tudsat-rocket/rapid_fancyfins/connector_pcb/connector_pcb.step

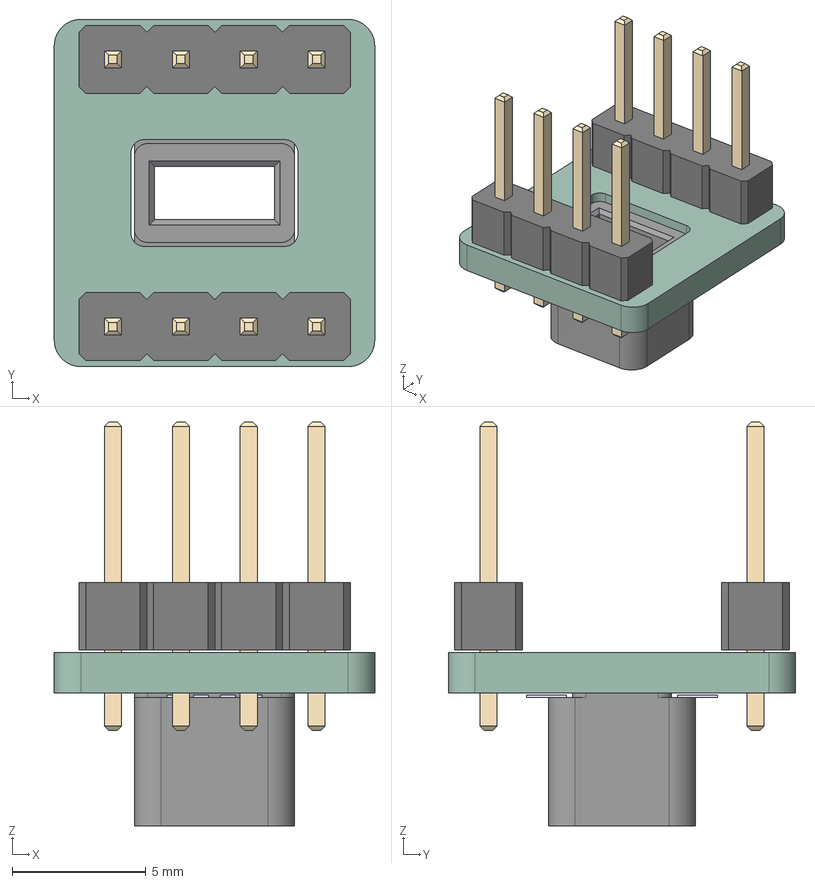
[picture p1: CAD file, 2025-07-23]
connector_pcb/connector_pcb.step
12.0 x 13.0 x 15.1 mm
PinHeader_1x04_P2.54mm_Vertical x 2
Pins
connector_pcb_PCB
