tudsat-rocket/rapid_fancyfins/fancyfins/frodo_fancyfins.step

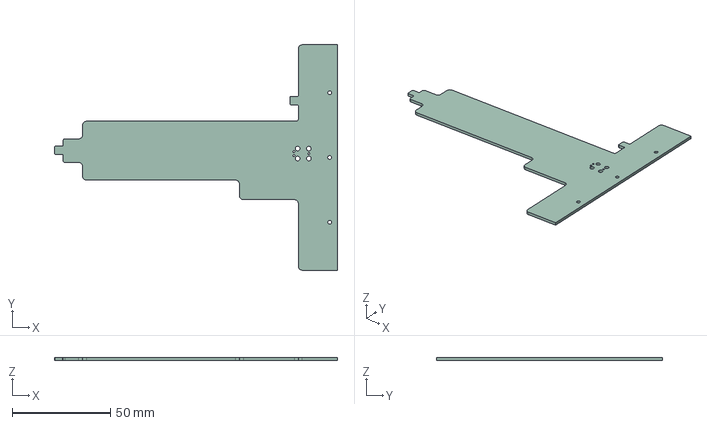
[picture p2: CAD file, 2025-07-23]
fancyfins/frodo_fancyfins.step
144.3 x 115.0 x 1.51 mm
