tudsat-rocket/rapid_fancyfins/sensor_pcb/sensor_pcb.step

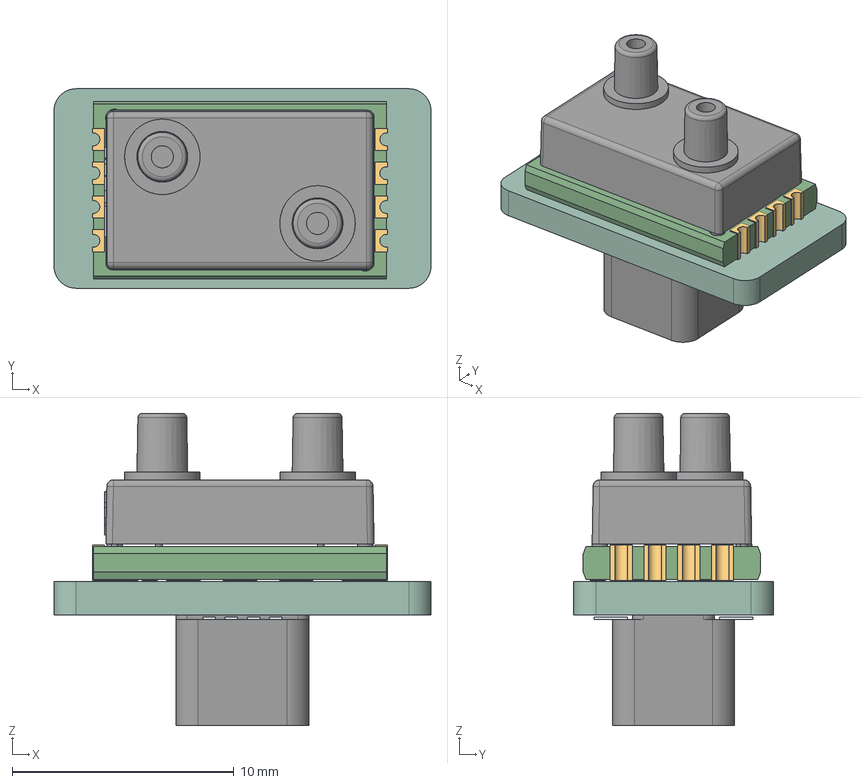
[picture p3: CAD file, 2025-07-23]
sensor_pcb/sensor_pcb.step
17.0 x 9.00 x 14.1 mm
8k_cover_V-strt_2.step
WE_logo.step
hpsd8000_PCBfull
Pins
sensor_pcb_PCB
