tudsat-rocket/rapid_fancyfins/common/3dmodels/STP_WL-ICLED_1313210530000.stp

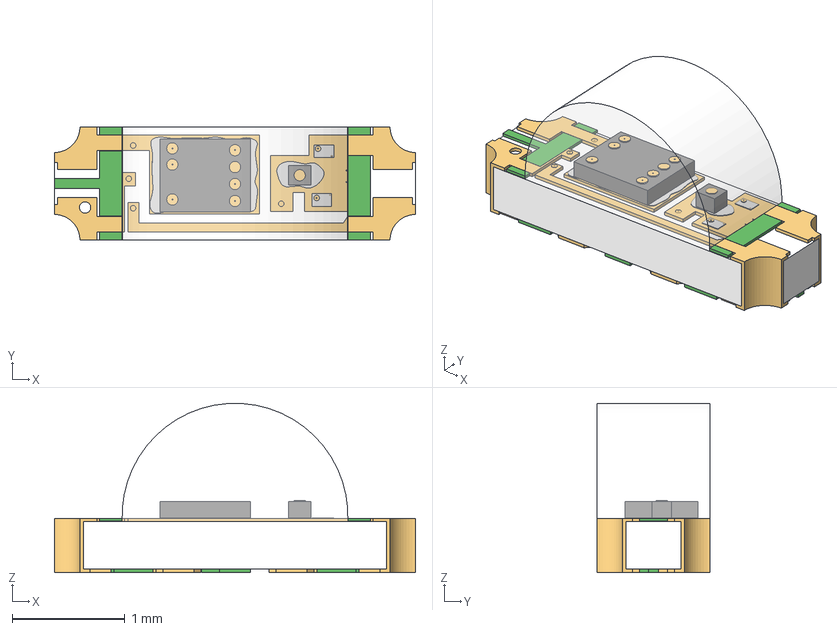
[picture p4: CAD file, 2025-03-25]
common/3dmodels/STP_WL-ICLED_1313210530000.stp
3.20 x 1.00 x 1.50 mm
Contacts
Resin
