tudsat-rocket/rapid_fancyfins/common/3dmodels/009159008801906.step

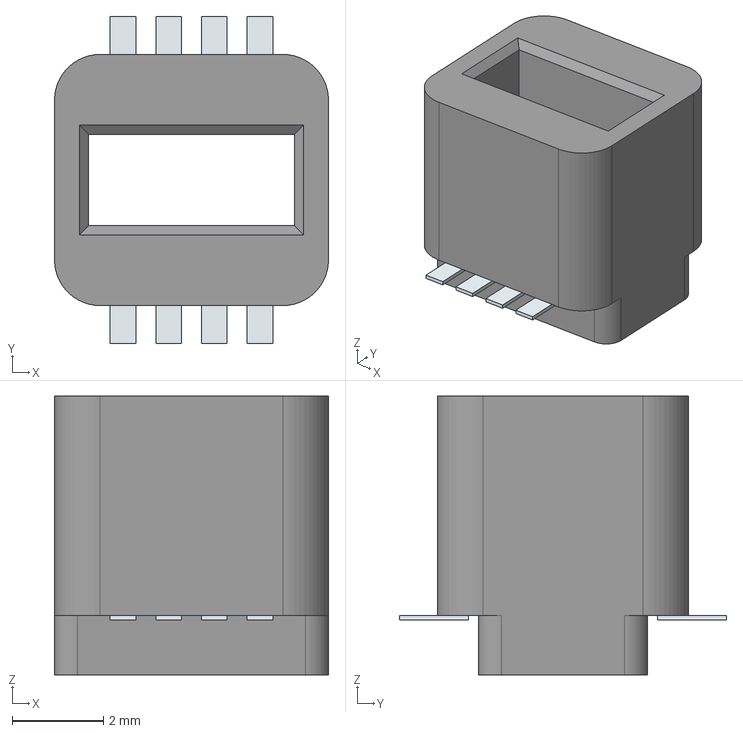
[picture p5: CAD file, 2025-04-08]
common/3dmodels/009159008801906.step
6.00 x 7.16 x 6.10 mm
Pins
