tudsat-rocket/rapid_fancyfins/common/3dmodels/2513130810001.stp

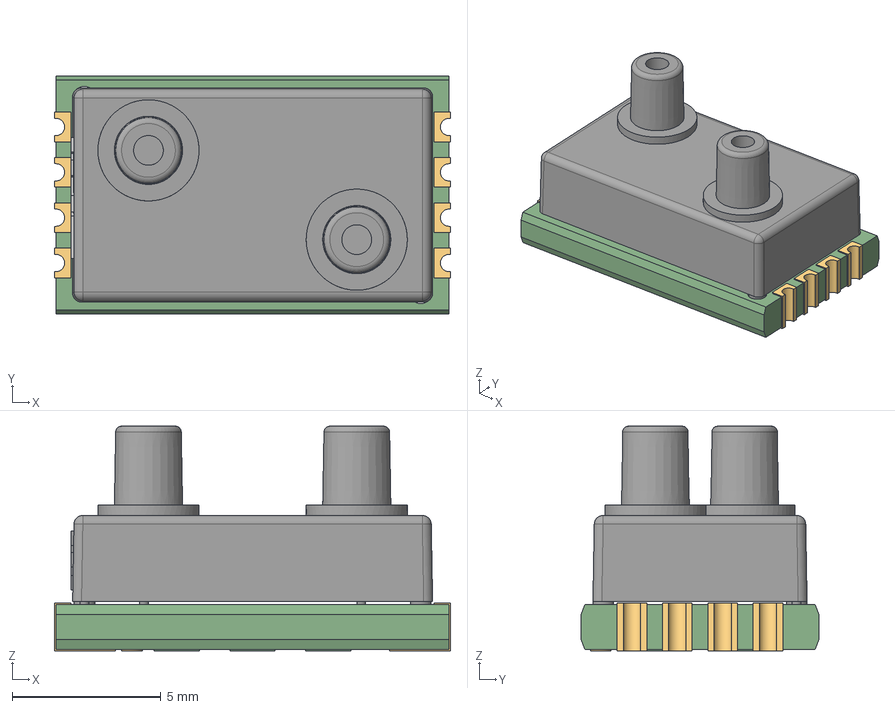
[picture p6: CAD file, 2025-04-08]
common/3dmodels/2513130810001.stp
13.3 x 8.00 x 7.55 mm
8k_cover_V-strt_2.step
WE_logo.step
hpsd8000_PCBfull
