tudsat-rocket/rapid_fancyfins/common/3dmodels/166087-4.stp

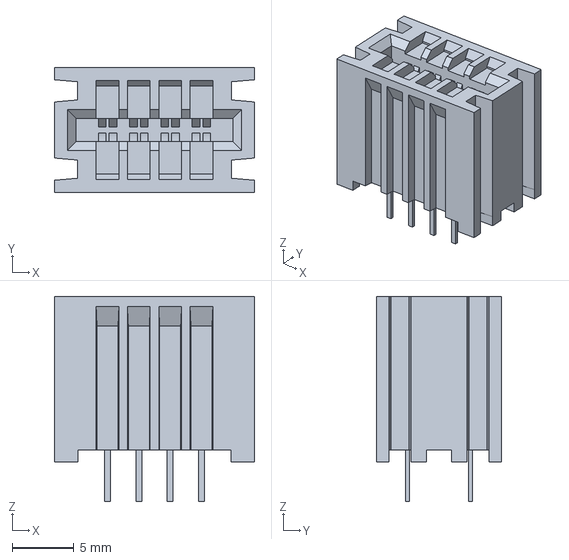
[picture p7: CAD file, 2025-03-25]
common/3dmodels/166087-4.stp
16.2 x 10.2 x 16.6 mm
