tudsat-rocket/rapid_fancyfins/fancyfins/frodo_fancyfins.kicad_pcb

## KiCad design fancyfins/frodo_fancyfins.kicad_pcb (2025-07-23)

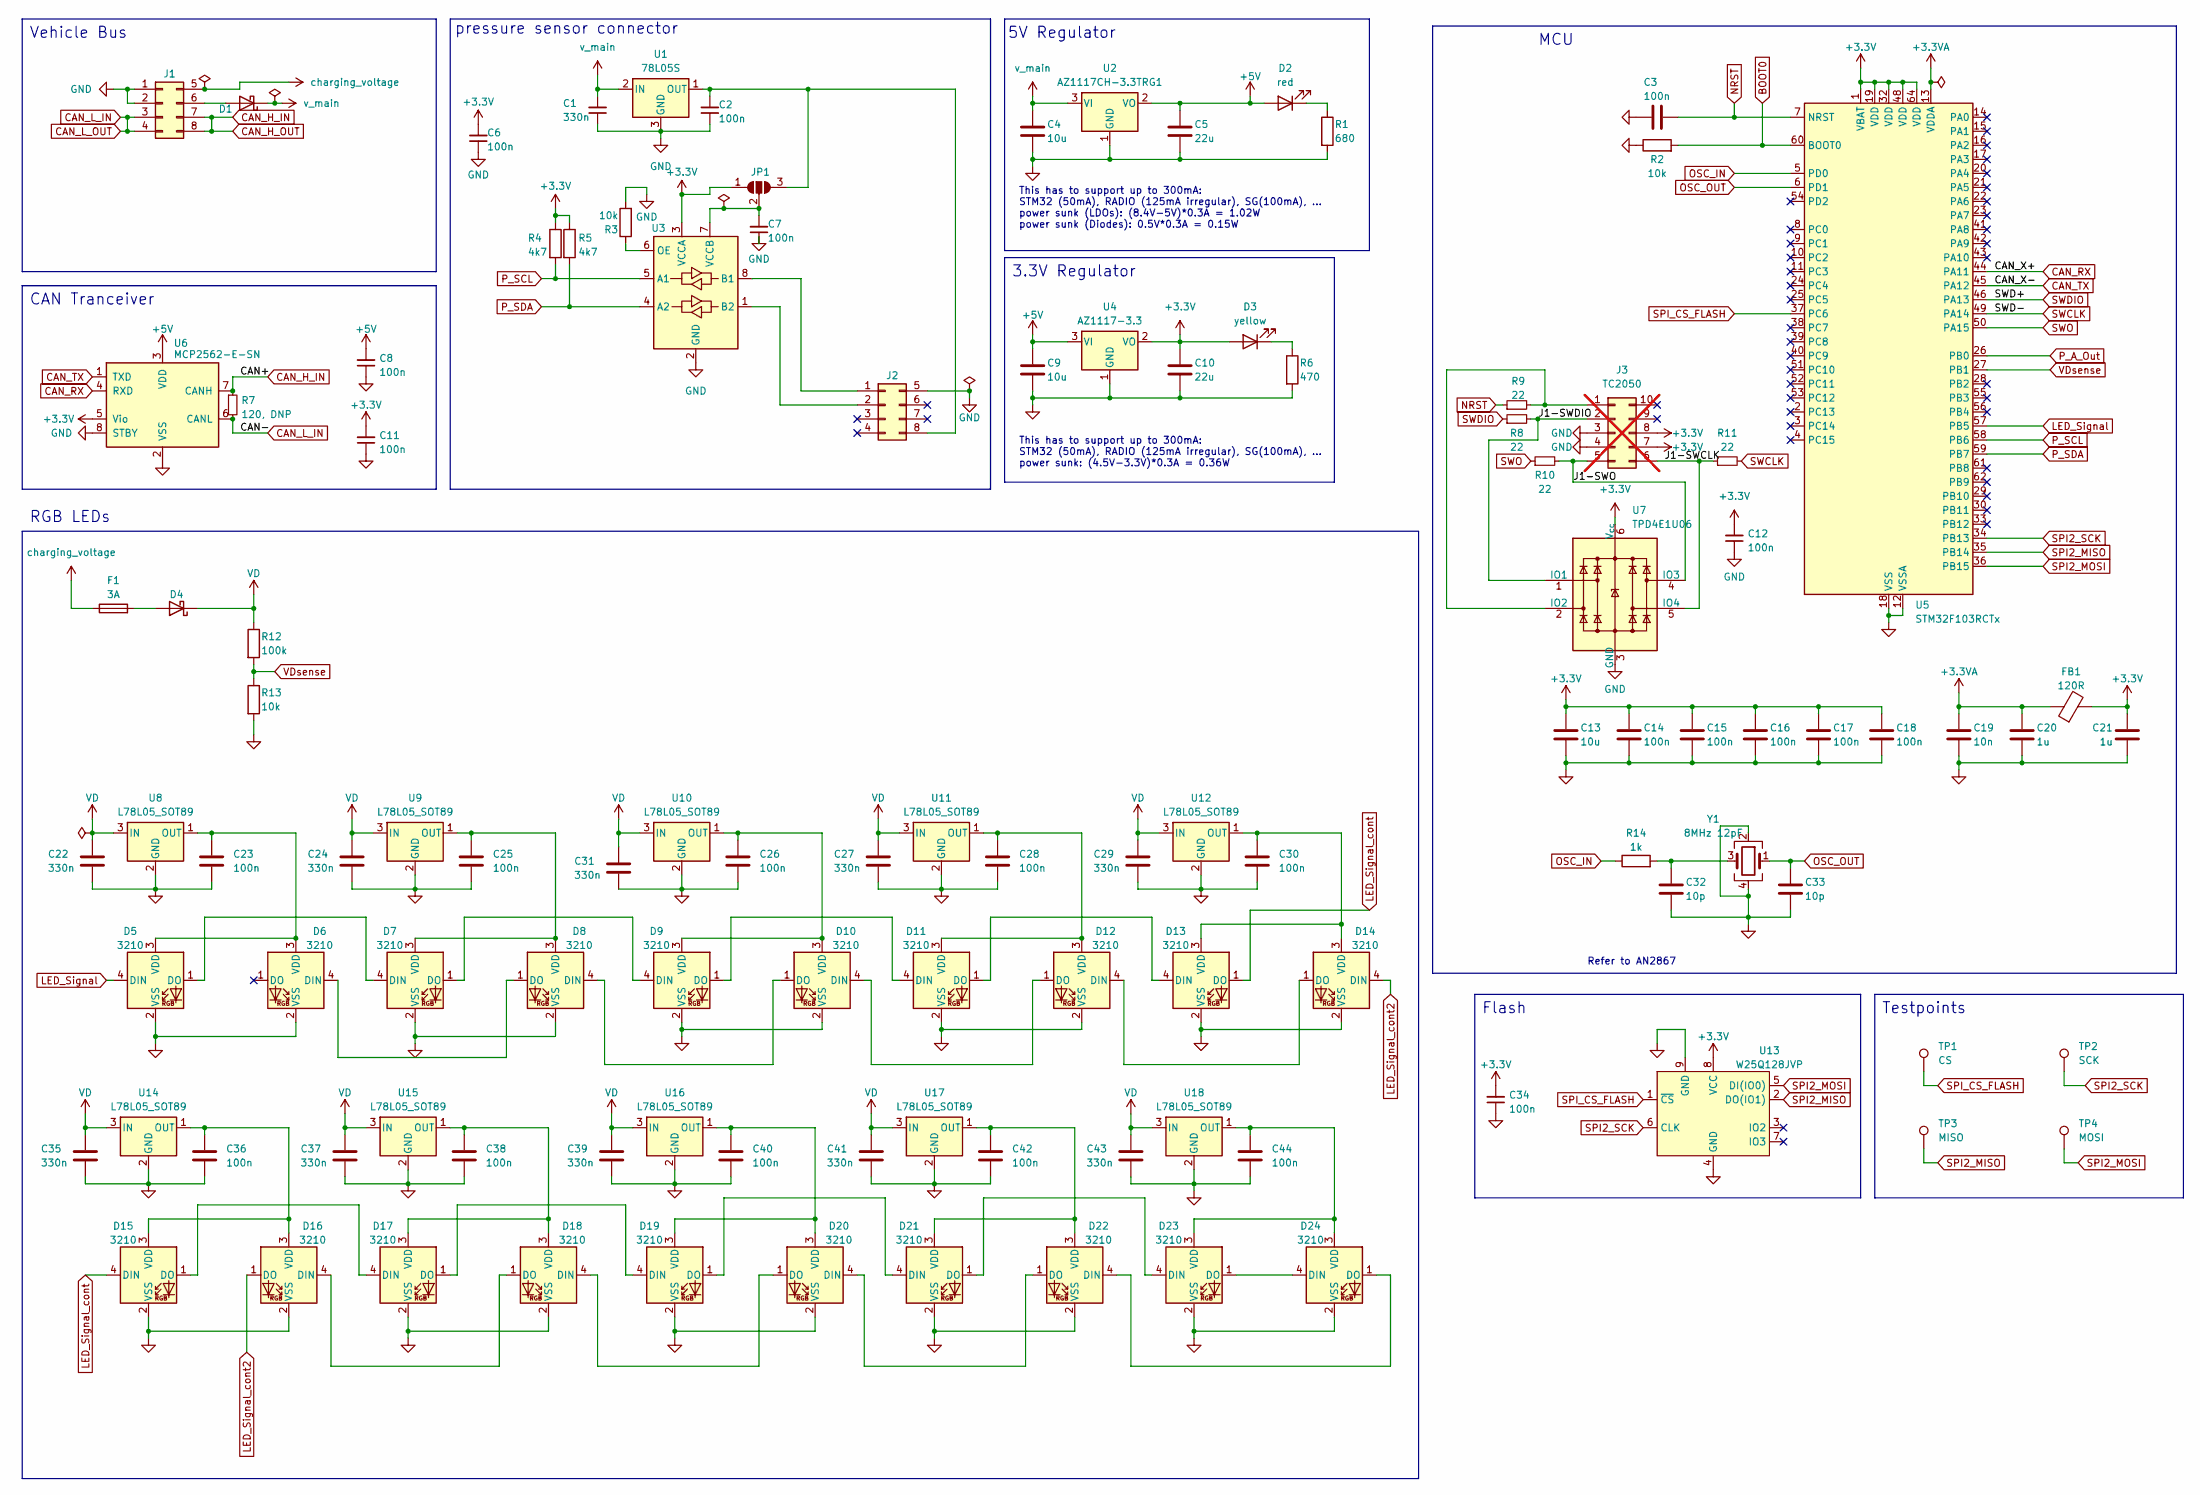
[picture p8: schematic frodo_fancyfins.kicad_sch]

Parts:
C1: 330n; C_0402_1005Metric
C2, C6, C7, C12: 100n; C_0402_1005Metric; Part# CL10B104KB8NNNC; LCSC C1525
C3, C8, C11, C14, C15, C16, C17, C18, C34: 100n; C_0402_1005Metric_Pad0.74x0.62mm_HandSolder; LCSC# C307331
C4, C9, C13: 10u; C_0603_1608Metric_Pad1.08x0.95mm_HandSolder; LCSC# C96446
C5, C10: 22u; C_0805_2012Metric_Pad1.18x1.45mm_HandSolder; LCSC# C45783
C19: 10n; C_0402_1005Metric; LCSC# C15195
C20, C21: 1u; C_0402_1005Metric; LCSC# C14445
C22, C24, C27, C29, C31, C35, C37, C39, C41, C43: 330n; C_0402_1005Metric; LCSC# C5448882
C23, C25, C26, C28, C30, C36, C38, C40, C42, C44: 100n; C_0402_1005Metric; LCSC# C1525
C32, C33: 10p; C_0402_1005Metric_Pad0.74x0.62mm_HandSolder; LCSC# C32949
D1: SK34; D_SMA; LCSC # C5140034
D2: red; LED_0603_1608Metric_Pad1.05x0.95mm_HandSolder; LCSC# C2286
D3: yellow; LED_0603_1608Metric_Pad1.05x0.95mm_HandSolder; LCSC# C72038
D4: SK34; D_SMA; LCSC# C5140034
D5, D6, D7, D8, D9, D10, D11, D12, D13, D14, D15, D16, D17, D18, D19, D20, D21, D22, D23, D24: 3210; 1313210530000
F1: 3A; Fuse_1206_3216Metric_Pad1.42x1.75mm_HandSolder
FB1: 120R; L_0402_1005Metric; LCSC# C1002
J1, J2: card_edge_connector_2x4
J3: TC2050; Tag-Connect_TC2050-IDC-FP_2x05_P1.27mm_Vertical; not fitted
JP1: SolderJumper_3_Open; SolderJumper-3_P1.3mm_Open_RoundedPad1.0x1.5mm
R1: 680; R_0603_1608Metric_Pad0.98x0.95mm_HandSolder; LCSC# C23228
R2, R3, R13: 10k; R_0402_1005Metric; LCSC# C25744
R4, R5: 4k7; R_0603_1608Metric
R6: 470; R_0402_1005Metric; LCSC# C25117
R7: 120, DNP; R_0603_1608Metric_Pad0.98x0.95mm_HandSolder
R8, R9, R10, R11: 22; R_0402_1005Metric; Part# RC0603FR-0710KL; LCSC C25092
R12: 100k; R_0402_1005Metric; LCSC# C25741
R14: 1k; R_0402_1005Metric; LCSC# C11702
TP1: CS; TestPoint_Pad_D2.0mm
TP2: SCK; TestPoint_Pad_D2.0mm
TP3: MISO; TestPoint_Pad_D2.0mm
TP4: MOSI; TestPoint_Pad_D2.0mm
U1: 78L05S; SOT-23; LCSC# C2983743
U2: AZ1117CH-3.3TRG1; SOT-223-3_TabPin2; LCSC# C92102
U3: TXB0102DCU; VSSOP-8_2.3x2mm_P0.5mm
U4: AZ1117-3.3; SOT-223-3_TabPin2; LCSC# C110474
U5: STM32F103RCTx; LQFP-64_10x10mm_P0.5mm; LCSC# C8323
U6: MCP2562-E-SN; SOIC-8_3.9x4.9mm_P1.27mm; DigiKey# MCP2562-H/SN
U7: TPD4E1U06; SOT-563; LCSC C527516
U8, U9, U10, U11, U12, U14, U15, U16, U17, U18: L78L05_SOT89; SOT-89-3; LCSC# C42738
U13: W25Q128JVP; WSON-8-1EP_6x5mm_P1.27mm_EP3.4x4.3mm; LCSC# C190862
Y1: 8MHz 12pF; Crystal_SMD_5032-4Pin_5.0x3.2mm; LCSC# C2149245

Connections:
+3.3V: C6.2, C10.1, C11.2, C12.2, C13.1, C14.1, C15.1, C16.1, C17.1, C18.1, C21.1, C34.2, D3.2 (A), FB1.2, J3.7, J3.8, JP1.1 (A), R4.1, R5.1, U3.3 (VCCA), U4.2 (VO), U5.1 (VBAT), U5.19 (VDD), U5.32 (VDD), U5.48 (VDD), U5.64 (VDD), U6.5 (Vio), U7.6 (V_{cc}), U13.8 (VCC)
+3.3VA: C19.1, C20.1, FB1.1, U5.13 (VDDA)
+5V: C5.1, C8.2, C9.1, D2.2 (A), U2.2 (VO), U4.3 (VI), U6.3 (VDD)
/J1-SWCLK: J3.6, R11.1, U7.5 (IO4)
/J1-SWDIO: J3.2, R8.2, U7.1 (IO1)
/J1-SWO: J3.5, R10.2, U7.4 (IO3)
BOOT0: R2.2, U5.60 (BOOT0)
CAN_H_IN: J1.7, J1.8, R7.1, U6.7 (CANH)
CAN_L_IN: J1.3, J1.4, R7.2, U6.6 (CANL)
CAN_RX: U5.44 (PA11), U6.4 (RXD)
CAN_TX: U5.45 (PA12), U6.1 (TXD)
GND: C1.1, C2.1, C3.2, C4.2, C5.2, C6.1, C7.1, C8.1, C9.2, C10.2, C11.1, C12.1, C13.2, C14.2, C15.2, C16.2, C17.2, C18.2, C19.2, C20.2, C21.2, C22.2, C23.2, C24.2, C25.2, C26.2, C27.2, C28.2, C29.2, C30.2, C31.2, C32.2, C33.2, C34.1, C35.2, C36.2, C37.2, C38.2, C39.2, C40.2, C41.2, C42.2, C43.2, C44.2, D5.2 (VSS), D6.2 (VSS), D7.2 (VSS), D8.2 (VSS), D9.2 (VSS), D10.2 (VSS), D11.2 (VSS), D12.2 (VSS), D13.2 (VSS), D14.2 (VSS), D15.2 (VSS), D16.2 (VSS), D17.2 (VSS), D18.2 (VSS), D19.2 (VSS), D20.2 (VSS), D21.2 (VSS), D22.2 (VSS), D23.2 (VSS), D24.2 (VSS), J1.1, J1.2, J2.5, J3.3, J3.4, R1.2, R2.1, R3.2, R6.2, R13.2, U1.3 (GND), U2.1 (GND), U3.2 (GND), U4.1 (GND), U5.12 (VSSA), U5.18 (VSS), U5.31 (VSS), U5.47 (VSS), U5.63 (VSS), U6.2 (VSS), U6.8 (STBY), U7.3 (GND), U8.2 (GND), U9.2 (GND), U10.2 (GND), U11.2 (GND), U12.2 (GND), U13.4 (GND), U13.9 (GND), U14.2 (GND), U15.2 (GND), U16.2 (GND), U17.2 (GND), U18.2 (GND), Y1.2, Y1.4
LED_Signal: D5.4 (DIN), U5.57 (PB5)
LED_Signal_cont: D13.1 (DO), D15.4 (DIN)
LED_Signal_cont2: D14.4 (DIN), D16.1 (DO)
NRST: C3.1, R9.1, U5.7 (NRST)
unnamed: C32.1, R14.2, Y1.3
unnamed: D1.2 (A), J1.6
unnamed: D2.1 (K), R1.1
unnamed: D3.1 (K), R6.1
unnamed: D4.2 (A), F1.2
unnamed: D5.1 (DO), D7.4 (DIN)
unnamed: C23.1, D5.3 (VDD), D6.3 (VDD), U8.1 (OUT)
unnamed: D6.4 (DIN), D8.1 (DO)
unnamed: D7.1 (DO), D9.4 (DIN)
unnamed: C25.1, D7.3 (VDD), D8.3 (VDD), U9.1 (OUT)
unnamed: D10.4 (DIN), D12.1 (DO)
unnamed: D8.4 (DIN), D10.1 (DO)
unnamed: C26.1, D9.3 (VDD), D10.3 (VDD), U10.1 (OUT)
unnamed: D9.1 (DO), D11.4 (DIN)
unnamed: D11.1 (DO), D13.4 (DIN)
unnamed: C28.1, D11.3 (VDD), D12.3 (VDD), U11.1 (OUT)
unnamed: D12.4 (DIN), D14.1 (DO)
unnamed: C30.1, D13.3 (VDD), D14.3 (VDD), U12.1 (OUT)
unnamed: D15.1 (DO), D17.4 (DIN)
unnamed: C36.1, D15.3 (VDD), D16.3 (VDD), U14.1 (OUT)
unnamed: D16.4 (DIN), D18.1 (DO)
unnamed: D17.1 (DO), D19.4 (DIN)
unnamed: C38.1, D17.3 (VDD), D18.3 (VDD), U15.1 (OUT)
unnamed: D18.4 (DIN), D20.1 (DO)
unnamed: D19.1 (DO), D21.4 (DIN)
unnamed: C40.1, D19.3 (VDD), D20.3 (VDD), U16.1 (OUT)
unnamed: D20.4 (DIN), D22.1 (DO)
unnamed: D21.1 (DO), D23.4 (DIN)
unnamed: C42.1, D21.3 (VDD), D22.3 (VDD), U17.1 (OUT)
unnamed: D22.4 (DIN), D24.1 (DO)
unnamed: D23.1 (DO), D24.4 (DIN)
unnamed: C44.1, D23.3 (VDD), D24.3 (VDD), U18.1 (OUT)
unnamed: J2.1, U3.8 (B1)
unnamed: J2.2, U3.1 (B2)
unnamed: C2.2, J2.8, JP1.3 (B), U1.1 (OUT)
unnamed: J3.1, R9.2, U7.2 (IO2)
unnamed: C7.2, JP1.2 (C), U3.7 (VCCB)
unnamed: R3.1, U3.6 (OE)
OSC_IN: R14.1, U5.5 (PD0)
OSC_OUT: C33.1, U5.6 (PD1), Y1.1
P_A_Out: U5.26 (PB0)
P_SCL: R4.2, U3.5 (A1), U5.58 (PB6)
P_SDA: R5.2, U3.4 (A2), U5.59 (PB7)
SPI2_MISO: TP3.1, U5.35 (PB14), U13.2 (DO(IO1))
SPI2_MOSI: TP4.1, U5.36 (PB15), U13.5 (DI(IO0))
SPI2_SCK: TP2.1, U5.34 (PB13), U13.6 (CLK)
SPI_CS_FLASH: TP1.1, U5.37 (PC6), U13.1 (~CS)
SWCLK: R11.2, U5.49 (PA14)
SWDIO: R8.1, U5.46 (PA13)
SWO: R10.1, U5.50 (PA15)
VD: C22.1, C24.1, C27.1, C29.1, C31.1, C35.1, C37.1, C39.1, C41.1, C43.1, D4.1 (K), R12.1, U8.3 (IN), U9.3 (IN), U10.3 (IN), U11.3 (IN), U12.3 (IN), U14.3 (IN), U15.3 (IN), U16.3 (IN), U17.3 (IN), U18.3 (IN)
VDsense: R12.2, R13.1, U5.27 (PB1)
charging_voltage: F1.1, J1.5
v_main: C1.2, C4.1, D1.1 (K), U1.2 (IN), U2.3 (VI)

Notes on the sheet:
This has to support up to 300mA: STM32 (50mA), RADIO (125mA irregular), SG(100mA), ... power sunk (LDOs): (8.4V-5V)*0.3A = 1.02W power sunk (Diodes): 0.5V*0.3A = 0.15W
Vehicle Bus
CAN Tranceiver
Flash
Refer to AN2867
5V Regulator
This has to support up to 300mA: STM32 (50mA), RADIO (125mA irregular), SG(100mA), ... power sunk: (4.5V-3.3V)*0.3A = 0.36W
3.3V Regulator
Testpoints
RGB LEDs
pressure sensor connector
MCU

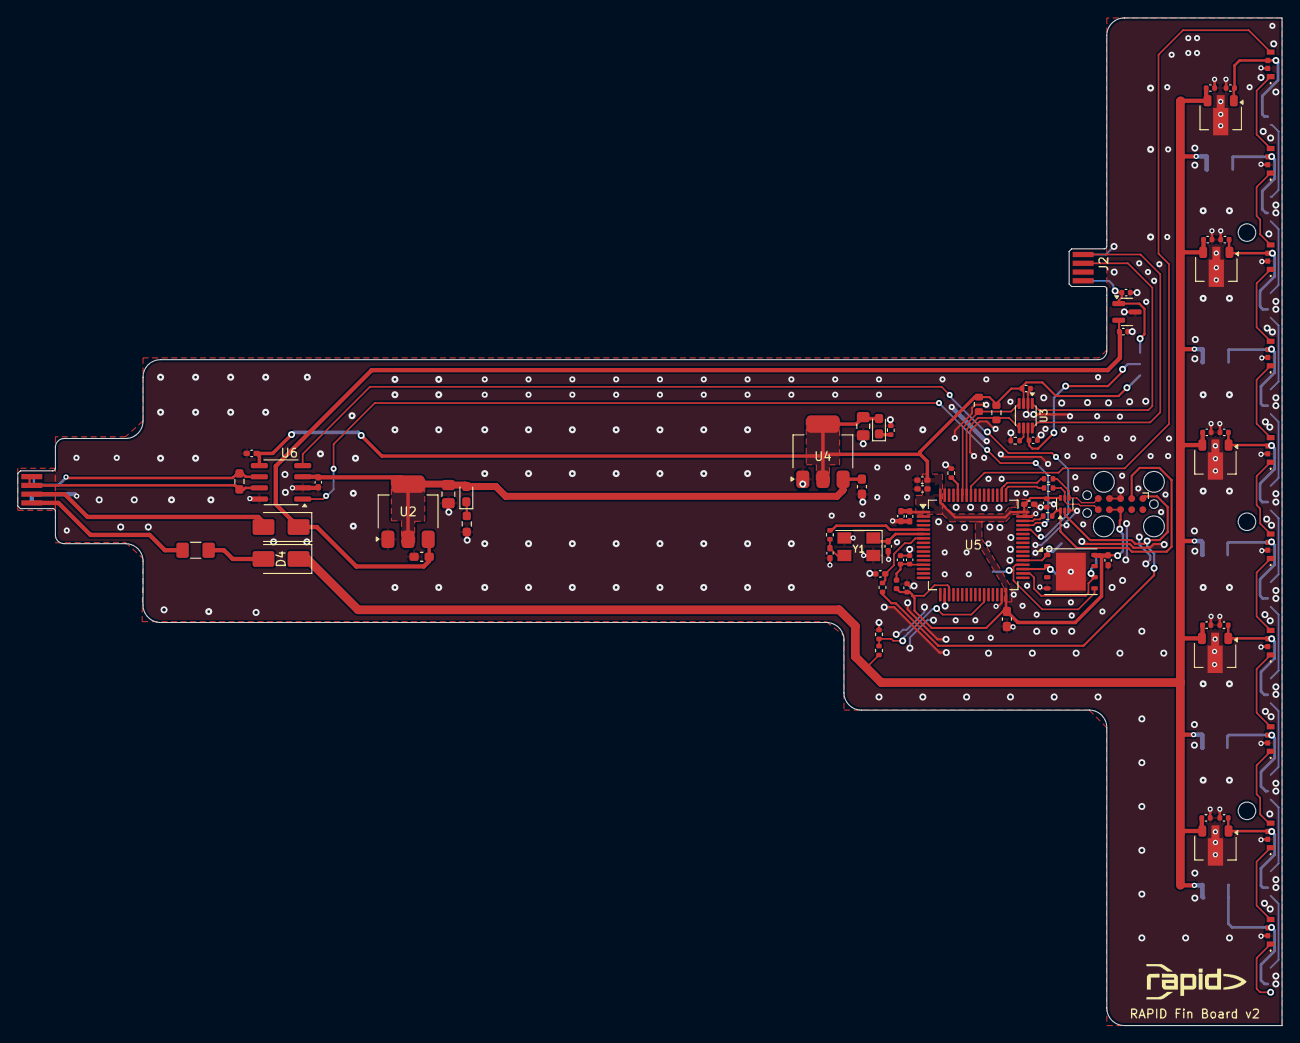
[picture p9: board frodo_fancyfins.kicad_pcb from above]

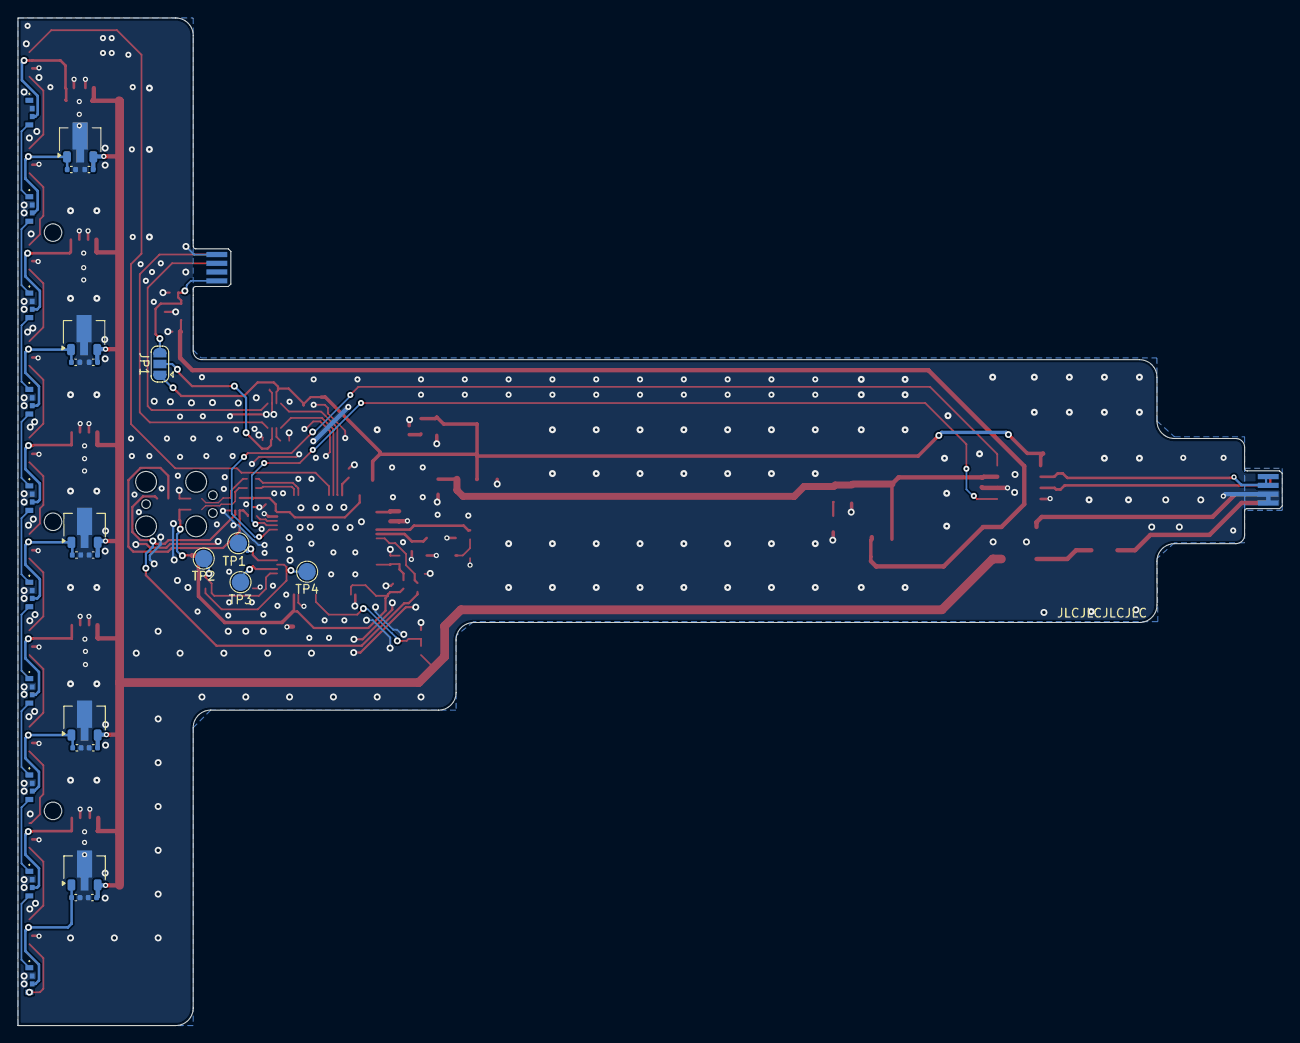
[picture p10: board frodo_fancyfins.kicad_pcb from below]

Board: 2 copper layers, 144.3 x 115.0 mm, 111 parts (31 on the bottom side), 69 nets.
