tudsat-rocket/rapid_fancyfins/connector_pcb/connector_pcb.kicad_pcb

## KiCad design connector_pcb/connector_pcb.kicad_pcb (2025-07-23)

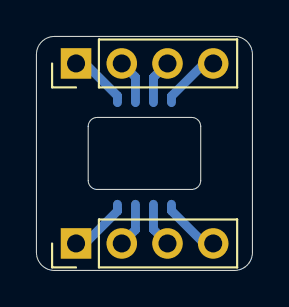
[picture p11: board connector_pcb.kicad_pcb from above]

Board: 2 copper layers, 12.0 x 13.0 mm, 3 parts (1 on the bottom side), 8 nets.

Parts:
J1: Conn_01x04_Pin; PinHeader_1x04_P2.54mm_Vertical
J2: PinHeader_1x04_P2.54mm_Vertical
J7: Conn_02x04_Top_Bottom; 009159008801906

Connections:
unnamed: J1.1, J7.1
unnamed: J1.2, J7.2
unnamed: J1.3, J7.3
unnamed: J1.4, J7.4
unnamed: J2.1, J7.5
unnamed: J2.2, J7.6
unnamed: J2.3, J7.7
unnamed: J2.4, J7.8
