tudsat-rocket/rapid_fancyfins/firmware/src/main.rs

#![no_std]
#![no_main]

use embassy_executor::Spawner;
use embassy_stm32::adc::Adc;
use embassy_stm32::Config;
use embassy_stm32::gpio::Input;
use embassy_stm32::peripherals::*;
use embassy_stm32::time::Hertz;
use embassy_stm32::wdg::IndependentWatchdog;
use embassy_sync::pubsub::PubSubChannel;
use embassy_time::{Duration, Ticker, Delay};

use {defmt_rtt as _, panic_probe as _};

mod can;
mod leds;
mod strain_gauge;

use can::*;

// TODO
#[global_allocator]
static ALLOCATOR: alloc_cortex_m::CortexMHeap = alloc_cortex_m::CortexMHeap::empty();

embassy_stm32::bind_interrupts!(struct Irqs {
    CAN1_RX1 => embassy_stm32::can::Rx1InterruptHandler<CAN>;
    CAN1_SCE => embassy_stm32::can::SceInterruptHandler<CAN>;
    USB_LP_CAN1_RX0 => embassy_stm32::can::Rx0InterruptHandler<CAN>;
    USB_HP_CAN1_TX => embassy_stm32::can::TxInterruptHandler<CAN>;
});

#[embassy_executor::task]
async fn iwdg_task(mut iwdg: IndependentWatchdog<'static, IWDG>) -> ! {
    let mut ticker = Ticker::every(Duration::from_millis(256));
    loop {
        iwdg.pet();
        ticker.next().await;
    }
}

#[embassy_executor::main]
async fn main(low_priority_spawner: Spawner) {
    let mut config = Config::default();
    config.rcc.hse = Some(Hertz::mhz(8));
    config.rcc.sys_ck = Some(Hertz::mhz(72));
    config.rcc.hclk = Some(Hertz::mhz(72));
    config.rcc.pclk1 = Some(Hertz::mhz(36));
    config.rcc.pclk2 = Some(Hertz::mhz(72));
    config.rcc.adcclk = Some(Hertz::mhz(14));
    let p = embassy_stm32::init(config);

    // Remap CAN to be on PB8/9
    embassy_stm32::pac::AFIO.mapr().modify(|w| w.set_can1_remap(2));

    let addr0 = Input::new(p.PA8, embassy_stm32::gpio::Pull::Up);
    let addr1 = Input::new(p.PA9, embassy_stm32::gpio::Pull::Up);
    let address = (addr0.is_low() as u8) << 1 + (addr1.is_low() as u8);
    // Fin #1 has a broken jumper, so hardcode this when flashing.
    //let address = 1;

    defmt::info!("Fin #{} startup", address);

    // Start watchdog
    let mut iwdg = IndependentWatchdog::new(p.IWDG, 512_000); // 512ms timeout
    iwdg.unleash();
    low_priority_spawner.spawn(iwdg_task(iwdg)).unwrap();

    let can_in = CAN_IN.init(PubSubChannel::new());
    let can_out = CAN_OUT.init(PubSubChannel::new());
    // Can RX on PB8 can TX on PB9
    let can = embassy_stm32::can::Can::new(p.CAN, p.PB8, p.PB9, Irqs);

    // Start main CAN RX/TX tasks
    can::spawn(can, low_priority_spawner, can_in.publisher().unwrap(), can_out.subscriber().unwrap()).await;

    // Run a task which listens to CAN messages and publishes flight mode information
    let flight_mode = FLIGHT_MODE.init(PubSubChannel::new());
    low_priority_spawner.spawn(can::run_flight_mode_listener(can_in.subscriber().unwrap(), flight_mode.publisher().unwrap())).unwrap();

    // Run LED task
    low_priority_spawner.spawn(leds::run(flight_mode.subscriber().unwrap(), p.SPI3, p.PB5, p.DMA1_CH1, p.DMA1_CH2)).unwrap();

    // Run strain gauge task. TODO: split flash into separate task?
    let mut adc = Adc::new(p.ADC1, &mut Delay);
    adc.set_sample_time(embassy_stm32::adc::SampleTime::Cycles239_5);

    low_priority_spawner.spawn(
        strain_gauge::run(
            address,
            adc,
            p.PC0,
            p.PC1,
            p.PC2,
            p.PC3,
            flight_mode.subscriber().unwrap(),
            can_out.publisher().unwrap()
        )
    ).unwrap();
}
