tudsat-rocket/rapid_fancyfins/(commit log)

2023-12-28 File structure cleanup
    [frodo_fancyfins.kicad_pcb, frodo_fancyfins.kicad_sch]
2024-01-17 Add INA826, antenna symbol and antenna footprint
    [frodo_fancyfins.kicad_sch, led_grouped.kicad_sch]
2024-01-17 Add RGB LED schematics
    [frodo_fancyfins.kicad_sch, led_grouped.kicad_sch]
2024-01-17 Schematics cleanup
    [frodo_fancyfins.kicad_sch, led_grouped.kicad_sch]
2024-01-18 Create symbol and footprint of RF module
2024-01-18 Add RF module to Schematics
    [frodo_fancyfins.kicad_sch]
2024-01-20 Add strain gauge schematics
    [frodo_fancyfins.kicad_sch, strain_gauge.kicad_sch]
2024-01-24 3.3V and 5V power supply tweaks
    [frodo_fancyfins.kicad_sch, strain_gauge.kicad_sch]
2024-01-25 Add commentary concerning power supply
    [frodo_fancyfins.kicad_sch]
2024-01-25 Add flash memory schematics
    [frodo_fancyfins.kicad_sch]
2024-01-26 Asign footprints, add missing footprints, adjust Rext.
    [frodo_fancyfins.kicad_sch, led_grouped.kicad_sch, strain_gauge.kicad_sch]
2024-01-30 Switch from STM32F072 to STM32F103, Add fin shape draft, Place component footprints
    [frodo_fancyfins.kicad_pcb, frodo_fancyfins.kicad_sch, strain_gauge.kicad_sch]
2024-02-01 PCB Layout (traces, edge cuts, silk screen, 3d models)
    [430450612.stp, frodo_fancyfins.kicad_pcb, frodo_fancyfins.kicad_sch, strain_gauge.kicad_sch]
2024-02-01 Minor changes for ordering
    [frodo_fancyfins.kicad_pcb]
2024-07-31 implement changes from rev 0 to rev 1
    [frodo_fancyfins.kicad_pcb, frodo_fancyfins.kicad_sch, strain_gauge.kicad_sch]
2024-07-31 add LCSC part numbers, tweak some footprints
    [frodo_fancyfins.kicad_pcb, frodo_fancyfins.kicad_sch, led_grouped.kicad_sch, strain_gauge.kicad_sch]
2024-08-11 Fix build issues, handle flash stuff in fin_tasks
    [main.rs]
2024-08-12 Check flight mode for recording and led output
2024-08-17 Add initalization for led driver and flash driver
2024-08-20 Separate strain gauge and LED modules, implement flight mode signal
2025-03-25 added new leds, edge connectors and flexpcb
    [166087-4.stp, 430450612.stp, STP_WL-ICLED_1313210530000.stp, fin_flex_cable.kicad_pcb, fin_flex_cable.kicad_sch, frodo_fancyfins.kicad_pcb, frodo_fancyfins.kicad_sch, led_grouped.kicad_sch]
2025-04-08 finished layout, added a bunch of footprints, fixed outer form
    [009159008801906.step, 2513130810001.stp, fin_flex_cable.kicad_pcb, fin_flex_cable.kicad_sch, frodo_fancyfins.kicad_pcb, frodo_fancyfins.kicad_sch, frodo_fancyfins.step, sensor_pcb.kicad_pcb]
2025-04-24 changed fancyfins layout a bit; added local footprint library
    [frodo_fancyfins.kicad_pcb, frodo_fancyfins.kicad_sch, led_grouped.kicad_sch]
2025-04-24 added fancy fins routing
    [frodo_fancyfins.kicad_pcb, frodo_fancyfins.kicad_sch]
2025-04-27 fixed some errors in the fancyfins pcb
    [frodo_fancyfins.kicad_pcb]
2025-04-27 fixed led symbol
    [frodo_fancyfins.kicad_pcb, frodo_fancyfins.kicad_sch, led_grouped.kicad_sch]
2025-04-27 changed fancyfinns pcb layout
    [frodo_fancyfins.kicad_pcb, frodo_fancyfins.kicad_sch]
2025-04-27 changed led routing
    [frodo_fancyfins.kicad_pcb]
2025-04-27 changed led position
    [frodo_fancyfins.kicad_pcb]
2025-04-27 changed scematic + examplary layout
    [frodo_fancyfins.kicad_pcb, frodo_fancyfins.kicad_sch]
2025-04-28 began fancyfin routing
    [frodo_fancyfins.kicad_pcb, frodo_fancyfins.kicad_sch]
2025-04-29 continued working on fancyfins routing
    [frodo_fancyfins.kicad_pcb]
2025-04-29 fixed gnd issue
    [frodo_fancyfins.kicad_pcb]
2025-04-29 added some vias for better gnd connection
    [frodo_fancyfins.kicad_pcb]
2025-04-29 finalized fancyfin routing (for now)
    [frodo_fancyfins.kicad_pcb, frodo_fancyfins.kicad_sch]
2025-06-09 finished routing for fin board
    [fin_flex_cable.kicad_sch, frodo_fancyfins.kicad_pcb, frodo_fancyfins.kicad_sch, frodo_fancyfins.step, parts.xlsx, sensor_pcb.kicad_sch]
2025-07-23 some changes according to manu, added connector board
    [connector_pcb.kicad_pcb, connector_pcb.kicad_sch, connector_pcb.step, fin_flex_cable.kicad_pcb, fin_flex_cable.kicad_sch, frodo_fancyfins.kicad_pcb, frodo_fancyfins.kicad_sch, frodo_fancyfins.step]
